KeithB-Media/3d-signs/lightbox/renders/wall_projecting.png

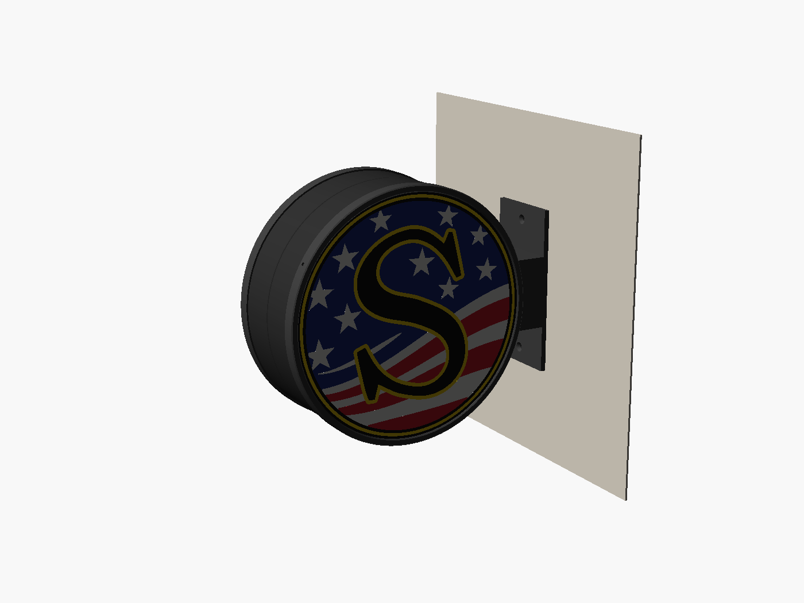
lightbox/renders/wall_projecting.png
