KeithB-Media/3d-signs/susquehanna-s/renders/centering_compare.png

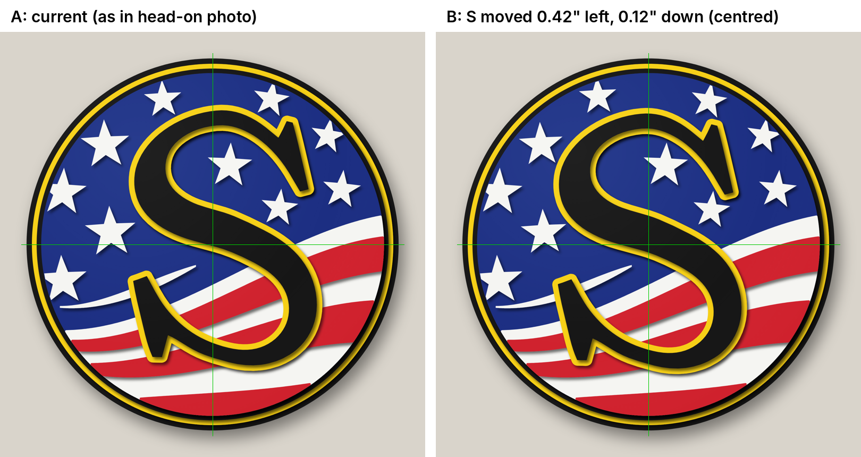
susquehanna-s/renders/centering_compare.png
