KeithB-Media/3d-signs/lightbox/stl/common/bezel.stl

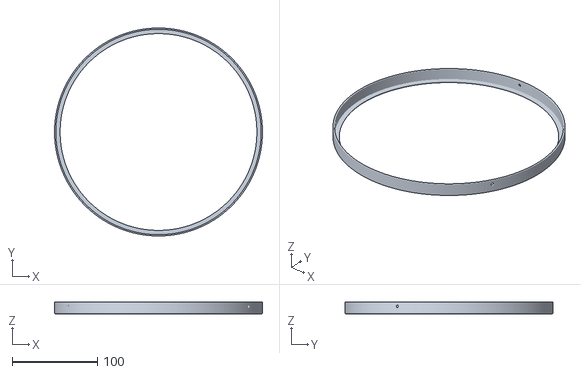
[picture p16: CAD file, 2026-11-11]
lightbox/stl/common/bezel.stl
243.8 x 243.8 x 13.8
