KeithB-Media/3d-signs/lightbox/stl/desk_stand/stand_wired.stl

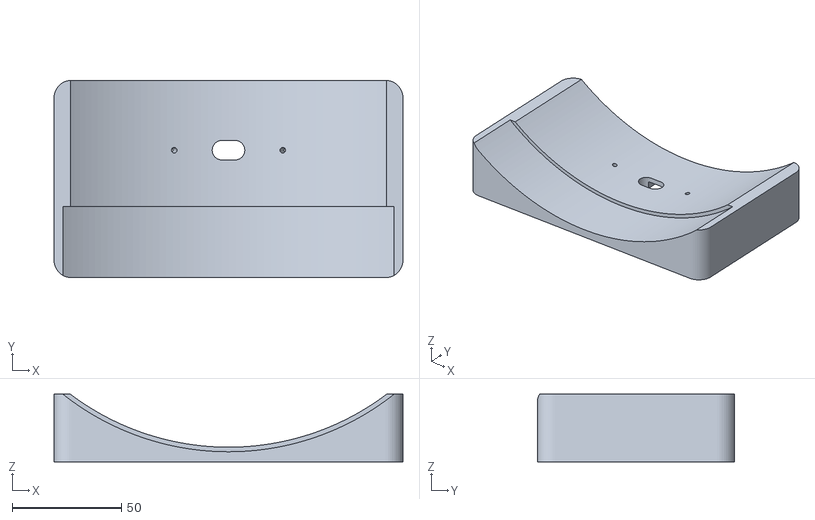
[picture p17: CAD file, 2026-11-11]
lightbox/stl/desk_stand/stand_wired.stl
160.0 x 90.4 x 31.0
