KeithB-Media/3d-signs/lightbox/stl/wall_flat/body_battery.stl

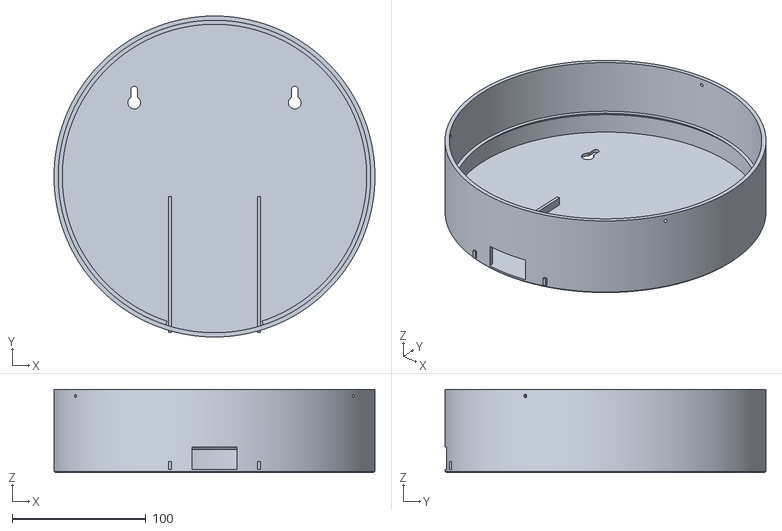
[picture p18: CAD file, 2026-11-11]
lightbox/stl/wall_flat/body_battery.stl
240.0 x 240.0 x 62.4
