KeithB-Media/3d-signs/lightbox/stl/wall_projecting/body_b.stl

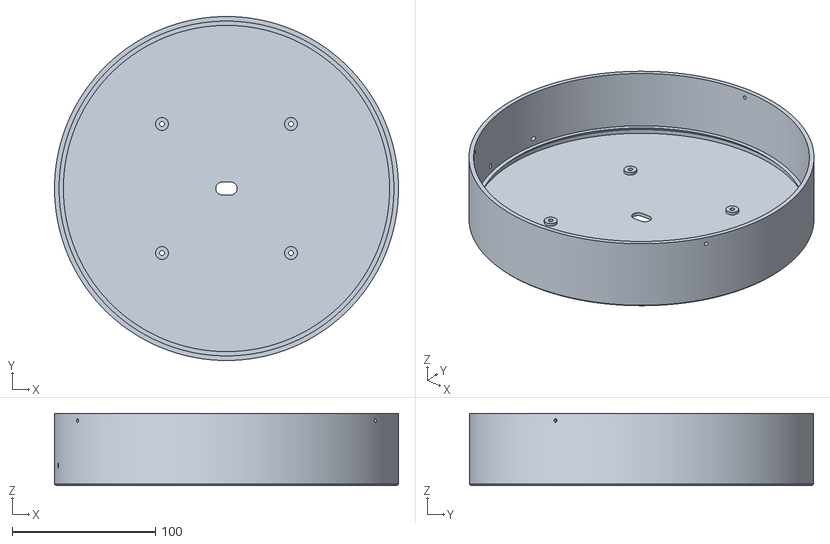
[picture p19: CAD file, 2026-11-11]
lightbox/stl/wall_projecting/body_b.stl
240.0 x 240.0 x 50.4
