KeithB-Media/3d-signs/lightbox/test/face_coupon/face_f5f5f2.stl

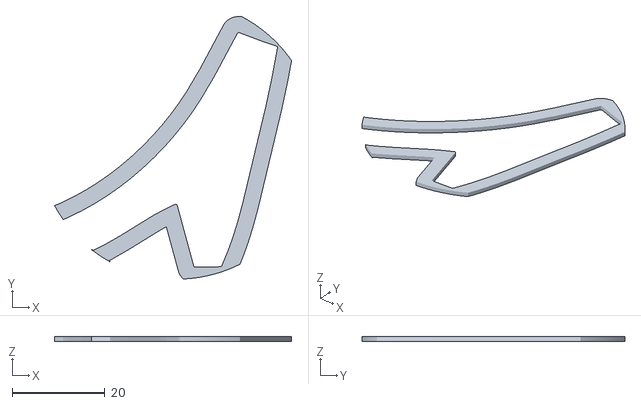
[picture p20: CAD file, 2026-11-11]
lightbox/test/face_coupon/face_f5f5f2.stl
51.1 x 56.7 x 1.00
