KeithB-Media/3d-signs/lightbox/test/full_size_fit/body_arc.stl

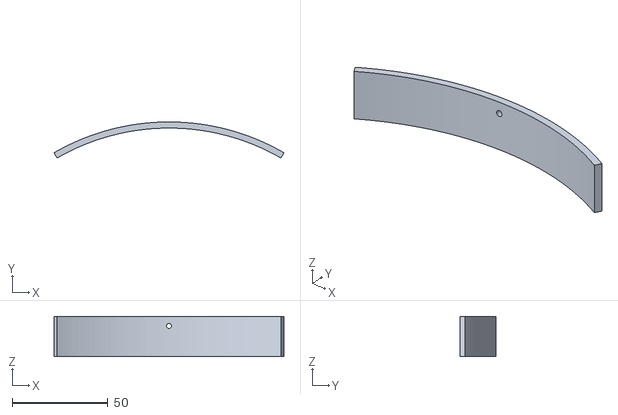
[picture p21: CAD file, 2026-11-11]
lightbox/test/full_size_fit/body_arc.stl
120.0 x 18.8 x 21.0
