KeithB-Media/3d-signs/lightbox/test/mini/led_plate.stl

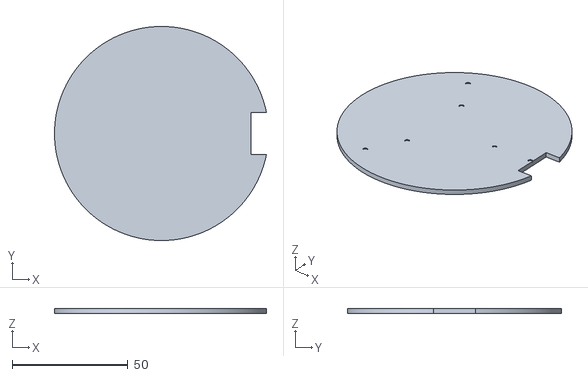
[picture p22: CAD file, 2026-11-11]
lightbox/test/mini/led_plate.stl
91.7 x 92.6 x 2.00
