KeithB-Media/3d-signs/susquehanna-s/lightbox_face/face_f6cf14.stl

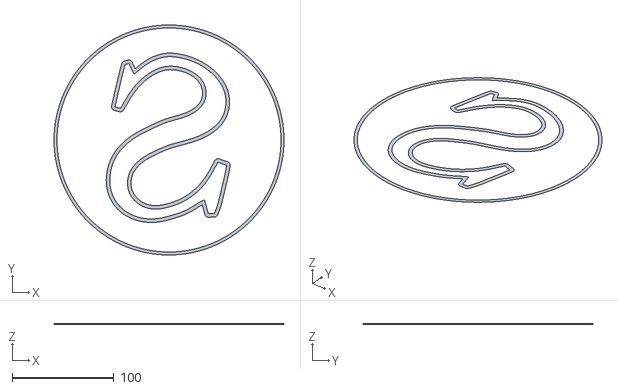
[picture p23: CAD file, 2026-11-11]
susquehanna-s/lightbox_face/face_f6cf14.stl
226.0 x 226.0 x 0.6
