KeithB-Media/3d-signs/lightbox/stl/common/led_plate.stl

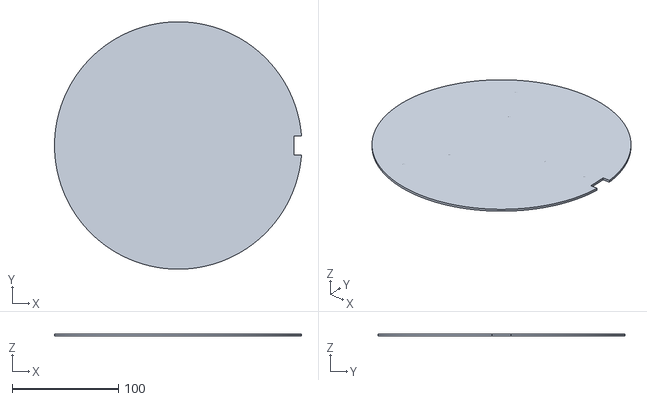
[picture p24: CAD file, 2026-11-11]
lightbox/stl/common/led_plate.stl
232.2 x 232.6 x 2.00
