KeithB-Media/3d-signs/lightbox/stl/desk_stand/stand_battery.stl

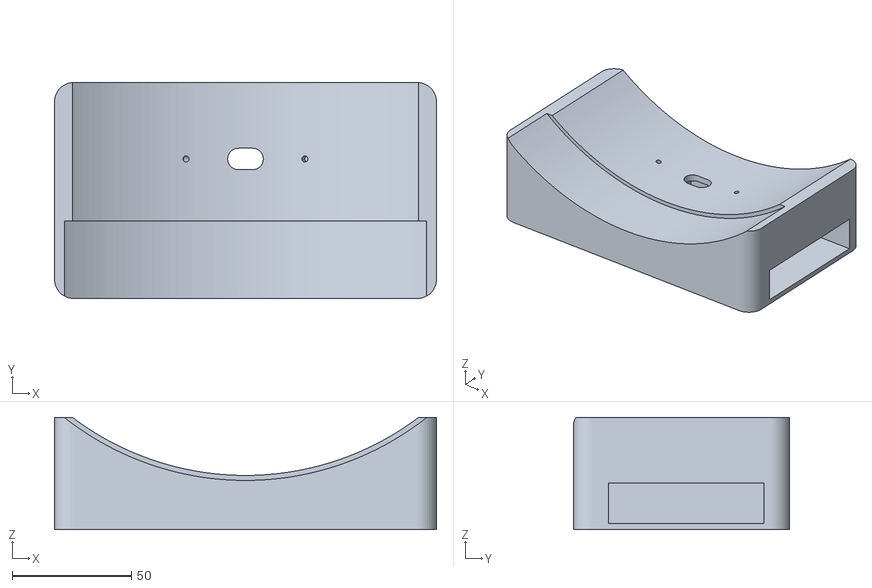
[picture p25: CAD file, 2026-11-11]
lightbox/stl/desk_stand/stand_battery.stl
160.0 x 90.4 x 47.0
