KeithB-Media/3d-signs/lightbox/stl/wall_projecting/arm.stl

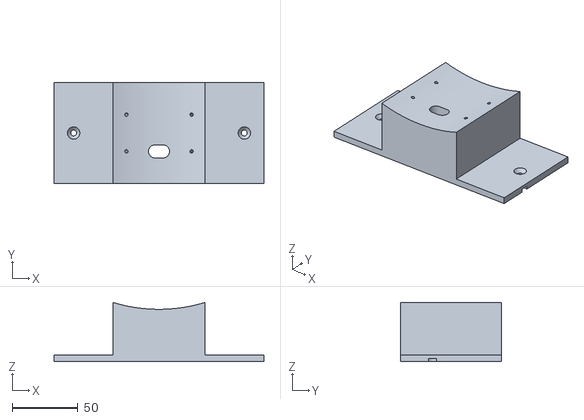
[picture p26: CAD file, 2026-11-11]
lightbox/stl/wall_projecting/arm.stl
160.0 x 76.8 x 45.0
