KeithB-Media/3d-signs/lightbox/test/face_coupon/face.3mf

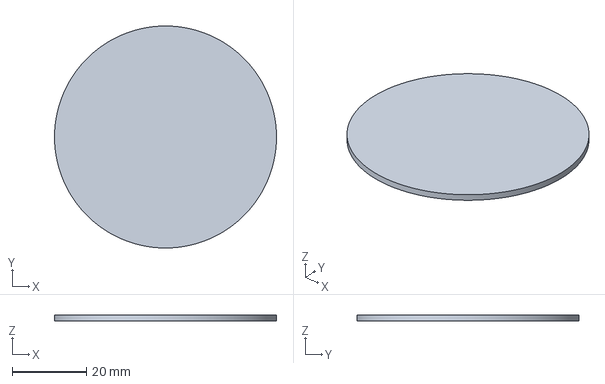
[picture p27: CAD file, 2026-11-11]
lightbox/test/face_coupon/face.3mf
60.0 x 60.0 x 1.60 mm
