KeithB-Media/3d-signs/lightbox/test/full_size_fit/bezel_arc.stl

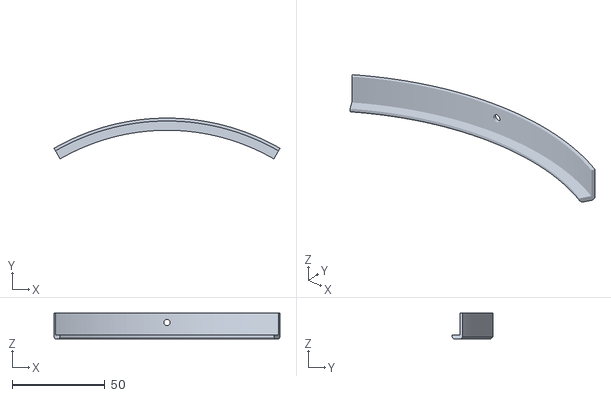
[picture p28: CAD file, 2026-11-11]
lightbox/test/full_size_fit/bezel_arc.stl
121.9 x 22.0 x 13.8
