KeithB-Media/3d-signs/lightbox/test/mini/face_f6cf14.stl

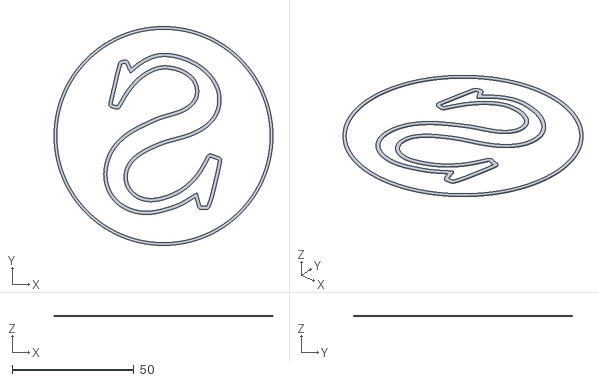
[picture p29: CAD file, 2026-11-11]
lightbox/test/mini/face_f6cf14.stl
90.0 x 90.0 x 0.6
