KeithB-Media/3d-signs/susquehanna-s/lightbox_face/face_141414.stl

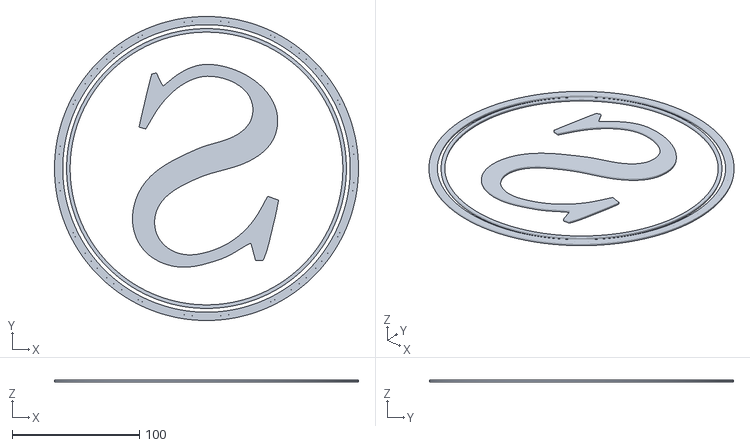
[picture p30: CAD file, 2026-11-11]
susquehanna-s/lightbox_face/face_141414.stl
239.0 x 239.0 x 1.60
