KeithB-Media/3d-signs/lightbox/stl/common/blank_face.stl

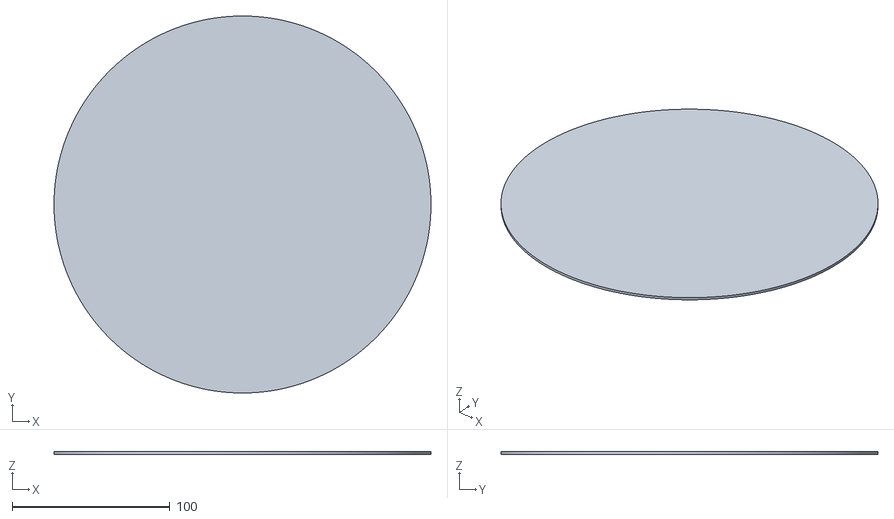
[picture p31: CAD file, 2026-11-10]
lightbox/stl/common/blank_face.stl
239.0 x 239.0 x 1.60
