KeithB-Media/3d-signs/lightbox/test/face_coupon/face_f6cf14.stl

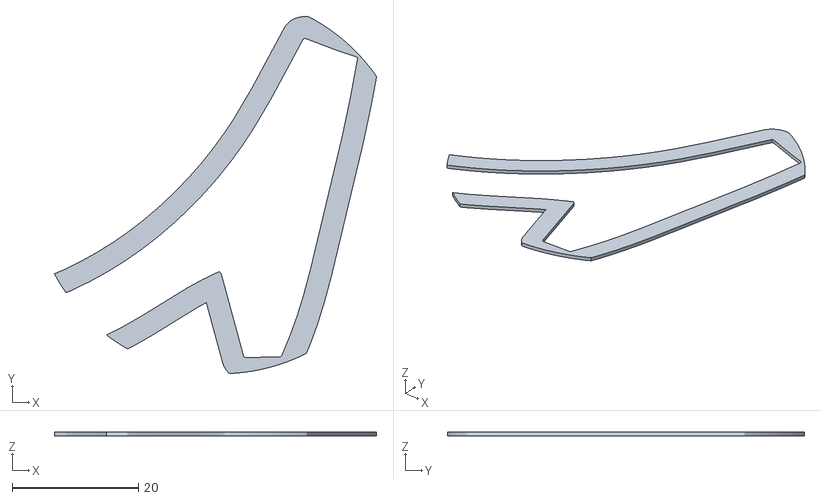
[picture p32: CAD file, 2026-11-11]
lightbox/test/face_coupon/face_f6cf14.stl
51.1 x 56.6 x 0.6
