KeithB-Media/3d-signs/lightbox/test/full_size_fit/face_arc.stl

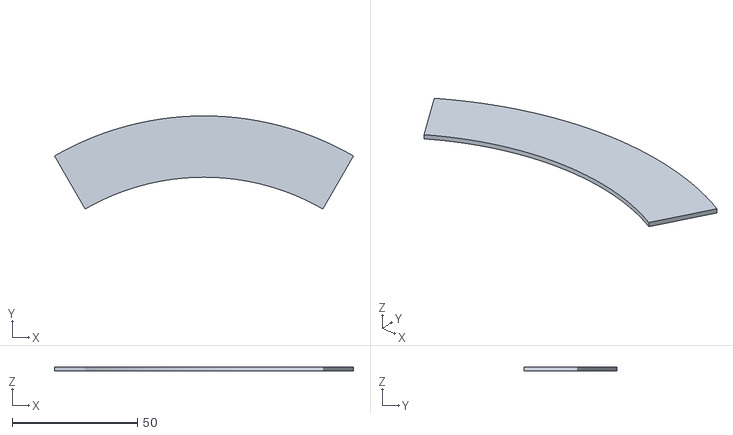
[picture p33: CAD file, 2026-11-11]
lightbox/test/full_size_fit/face_arc.stl
119.5 x 37.2 x 1.60
