KeithB-Media/3d-signs/lightbox/test/mini/body.stl

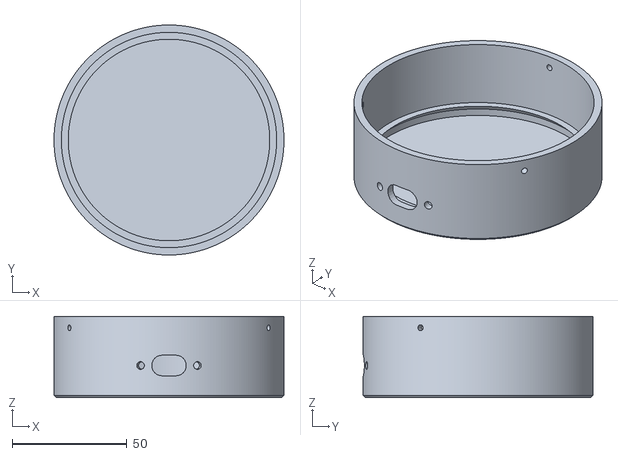
[picture p34: CAD file, 2026-11-11]
lightbox/test/mini/body.stl
100.0 x 100.0 x 35.4
