KeithB-Media/3d-signs/susquehanna-s/lightbox_face/face.3mf

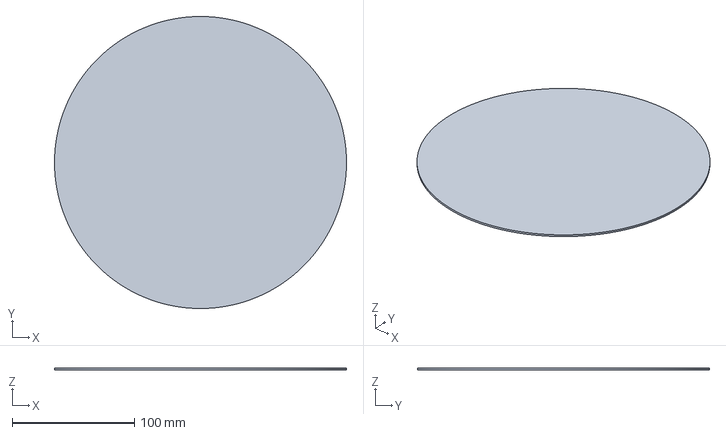
[picture p35: CAD file, 2026-11-11]
susquehanna-s/lightbox_face/face.3mf
239.0 x 239.0 x 1.60 mm
