KeithB-Media/3d-signs/lightbox/test/face_coupon/face_141414.stl

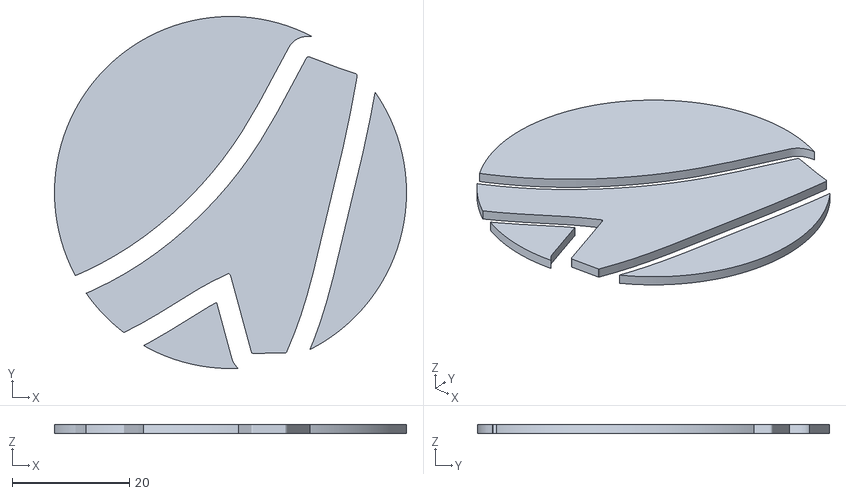
[picture p36: CAD file, 2026-11-11]
lightbox/test/face_coupon/face_141414.stl
60.0 x 60.0 x 1.60
