KeithB-Media/3d-signs/lightbox/test/mini/stand.stl

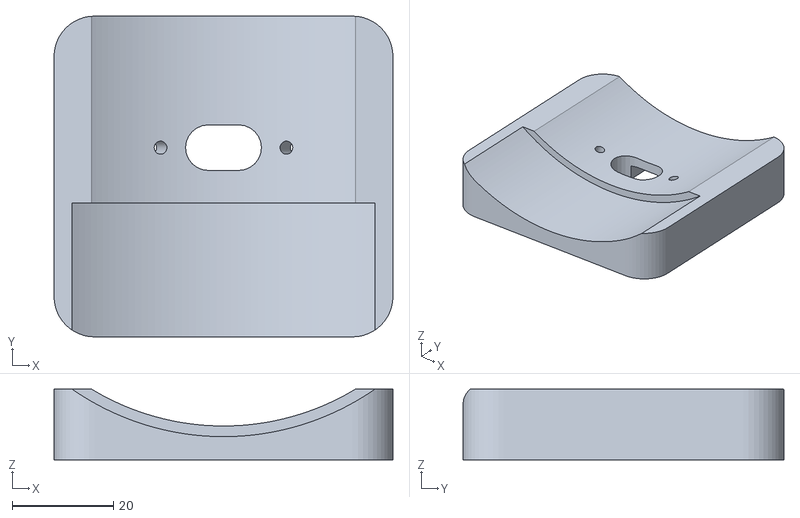
[picture p37: CAD file, 2026-11-11]
lightbox/test/mini/stand.stl
67.0 x 63.4 x 14.0
