KeithB-Media/3d-signs/susquehanna-s/lightbox_face/face_1f2f82.stl

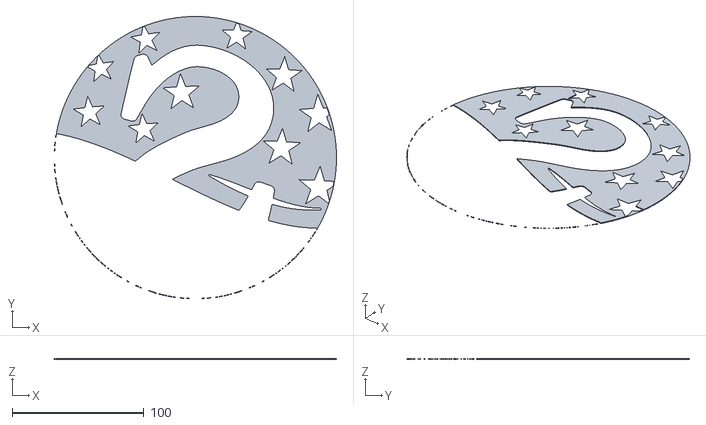
[picture p38: CAD file, 2026-11-11]
susquehanna-s/lightbox_face/face_1f2f82.stl
214.2 x 214.2 x 0.6
