KeithB-Media/3d-signs/lightbox/test/mini/bezel.stl

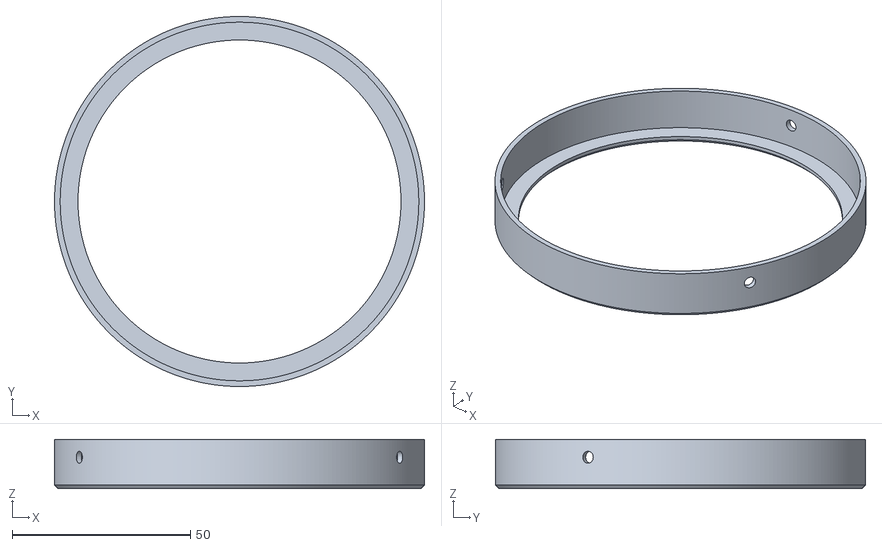
[picture p39: CAD file, 2026-11-11]
lightbox/test/mini/bezel.stl
103.8 x 103.8 x 13.8
