KeithB-Media/3d-signs/susquehanna-s/lightbox_face/face_d0202e.stl

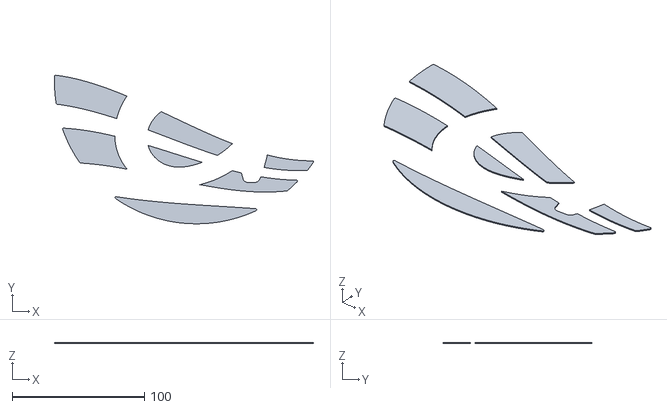
[picture p40: CAD file, 2026-11-11]
susquehanna-s/lightbox_face/face_d0202e.stl
195.6 x 112.2 x 0.6
