KeithB-Media/3d-signs/lightbox/test/mini/face_141414.stl

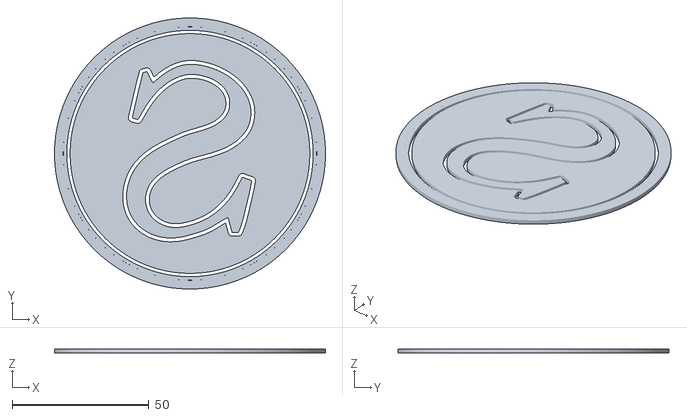
[picture p41: CAD file, 2026-11-11]
lightbox/test/mini/face_141414.stl
99.0 x 99.0 x 1.60
