KeithB-Media/3d-signs/susquehanna-s/lightbox_face/face_f5f5f2.stl

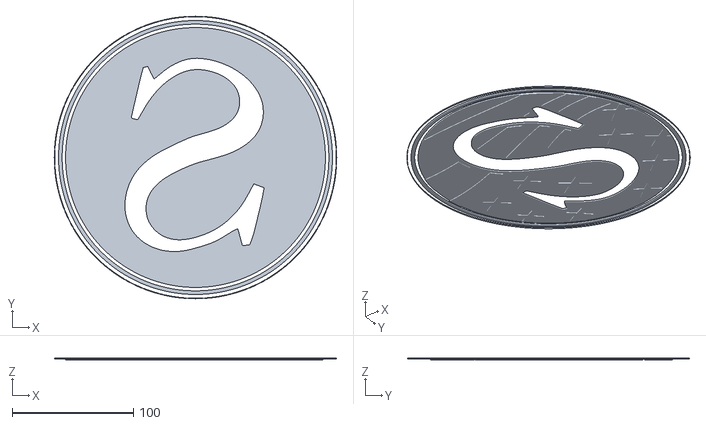
[picture p42: CAD file, 2026-11-11]
susquehanna-s/lightbox_face/face_f5f5f2.stl
232.6 x 232.6 x 1.60
