KeithB-Media/3d-signs/lightbox/test/mini/face.3mf

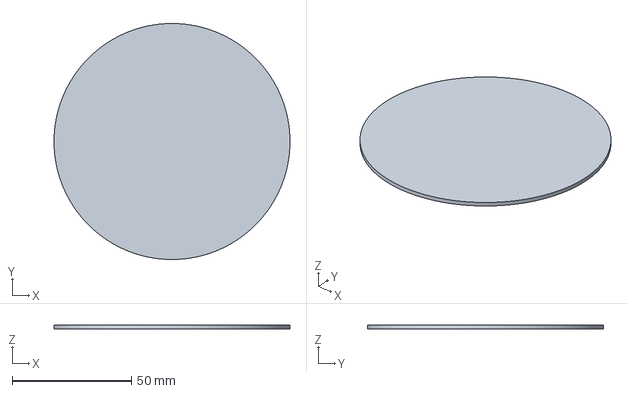
[picture p43: CAD file, 2026-11-11]
lightbox/test/mini/face.3mf
99.0 x 99.0 x 1.60 mm
