KeithB-Media/3d-signs/lightbox/test/mini/face_f5f5f2.stl

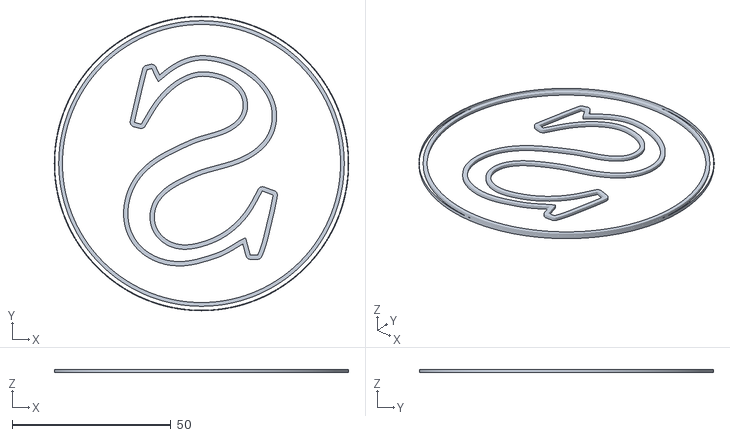
[picture p44: CAD file, 2026-11-11]
lightbox/test/mini/face_f5f5f2.stl
92.6 x 92.6 x 1.00
