KeithB-Media/3d-signs/(list of files, cad)

Other CAD files:
lightbox/stl/wall_flat/body_wired.stl
lightbox/stl/desk_stand/body.stl
lightbox/stl/wall_projecting/body_a_wired.stl
lightbox/stl/wall_projecting/body_a_battery.stl
