KeithB-Media/3d-signs/lightbox/test/mini/face_daylight.png

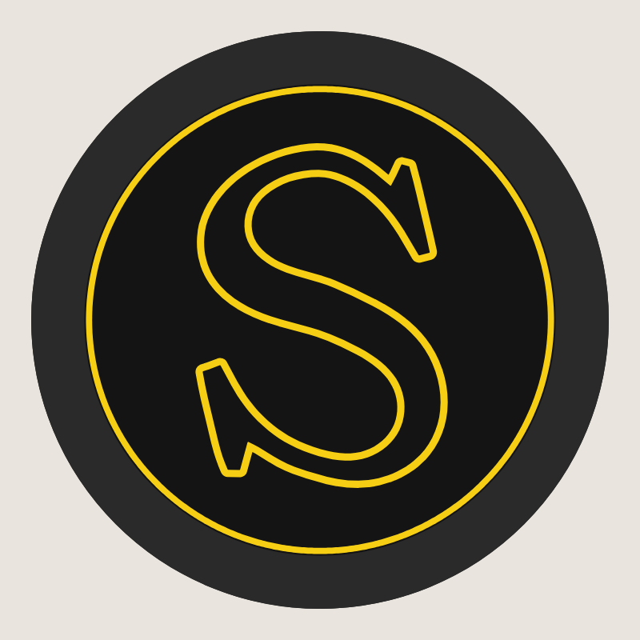
lightbox/test/mini/face_daylight.png
