KeithB-Media/3d-signs/(commit log)

2026-11-07 Add 14in 8-layer stacked Susquehanna S sign: cut SVGs, generator, renders
    Claude-Session: https://claude.ai/code/session_01Tymp3YH8hm1RbGtHM7Rnwr
2026-11-07 Trace the S from the locomotive logo instead of using a font
    - trace_s.py extracts the black S inside the yellow outline from a head-on photo,
    smooths curves with serif corners/spurs kept sharp, and repairs a glare dent
    - s_logo_trace.json holds the traced letter; generate.py uses it (font removed)
    - Yellow outline widened to the measured 0.21in
    - With the narrower top of the real S, the stars fit at (or near) full size
    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
2026-11-07 Add simplified one-tone engraved coaster version (4in and 3.5in)
    - coaster.py: engrave = outer ring, blue field, red stripes, S; bare wood = pinstripe,
    white stripes, stars, swoosh, widened S outline; optional cut circle
    - coaster_render.js: maple preview
    - generate.py: split artwork into parts() so the coaster reuses the sign geometry
    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
2026-11-10 Add round light-box system and printable glowing face for the Susquehanna sign
    face.py turns a flat colour SVG into a multi-colour face printed face-down on the
    P1S (0.6 mm colour skin over 1.0 mm white, black full thickness). lightbox.scad
    holds the shared bezel, LED plate and cup body; wall_flat, desk_stand and
    wall_projecting build the three styles, each wired or battery (USB power bank).
    Claude-Session: https://claude.ai/code/session_01Tymp3aU9Hg87HWoTfq3vgb
    [arm.stl, bezel.stl, blank_face.stl, body.stl, body_a_battery.stl, body_a_wired.stl, body_b.stl, body_battery.stl]
2026-11-10 Add test print set: face colour coupon, full-size fit slices, 4in mini box
    face.py gains --coupon to cut a small test piece from a face; white skin now
    overlaps the backing so the white part is always watertight. Keyholes, LED
    marks, stand width and mount spacing scale with the box size.
    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
    [arm.stl, bezel.stl, bezel_arc.stl, body.stl, body_a_battery.stl, body_a_wired.stl, body_arc.stl, body_b.stl]
2026-11-10 Use the yellow S (no flag) for the light-box test faces
    yellow_s.py writes a black/yellow-only flat SVG of the logo. The test coupon and
    4in mini face now use it: 3 filaments (black, yellow, hidden white backing), so
    the test fits a single AMS. face.py gains --backing to choose the backing colour.
    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
    [face.3mf, face_141414.stl, face_1f2f82.stl, face_d0202e.stl, face_f5f5f2.stl, face_f6cf14.stl, test_mini.scad]
2026-11-11 Slim the bezel's front rim from 10.7 mm to 6.6 mm
    The window was kept small to hide the screw bosses inside the body. The bosses
    are gone: the body wall is now 3.2 mm and the bezel screws (M3 x 6) bite straight
    into it. The bezel skirt is 1.6 mm and the window is od - 2*wall - 3 (230.6 mm
    full size, 90.6 mm mini). Faces, test files and STLs regenerated.
    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
    [arm.stl, bezel.stl, bezel_arc.stl, body.stl, body_a_battery.stl, body_a_wired.stl, body_arc.stl, body_b.stl]
